ShawnHymel/YAS-0/Documentation/part-creation.png

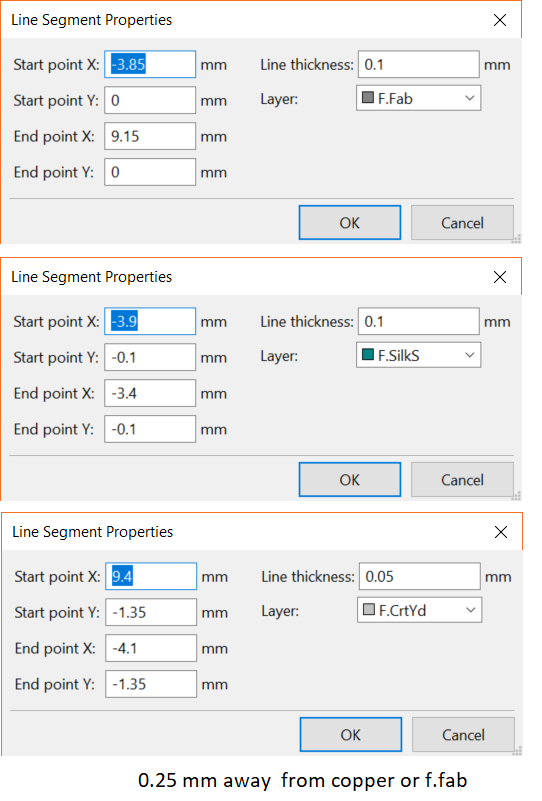
Documentation/part-creation.png
