ShawnHymel/YAS-0/Documentation/usb-impedance-calculation.png

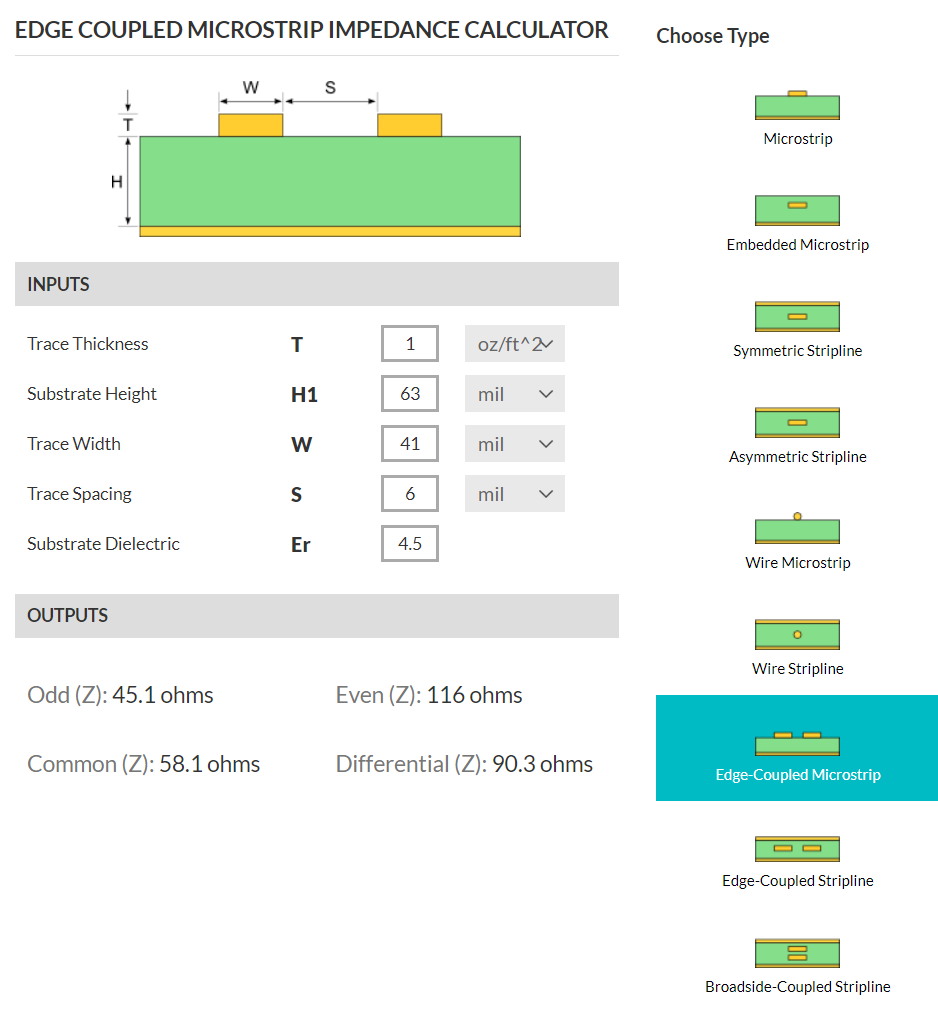
Documentation/usb-impedance-calculation.png
