ShawnHymel/YAS-0/Images/oshw-symbol.png

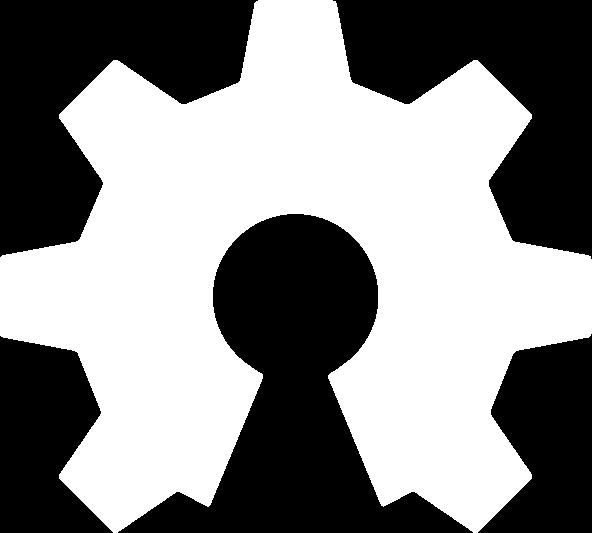
Images/oshw-symbol.png
