ShawnHymel/YAS-0/Hardware/STM32F070_Breakout/STM32F070_Breakout.pdf

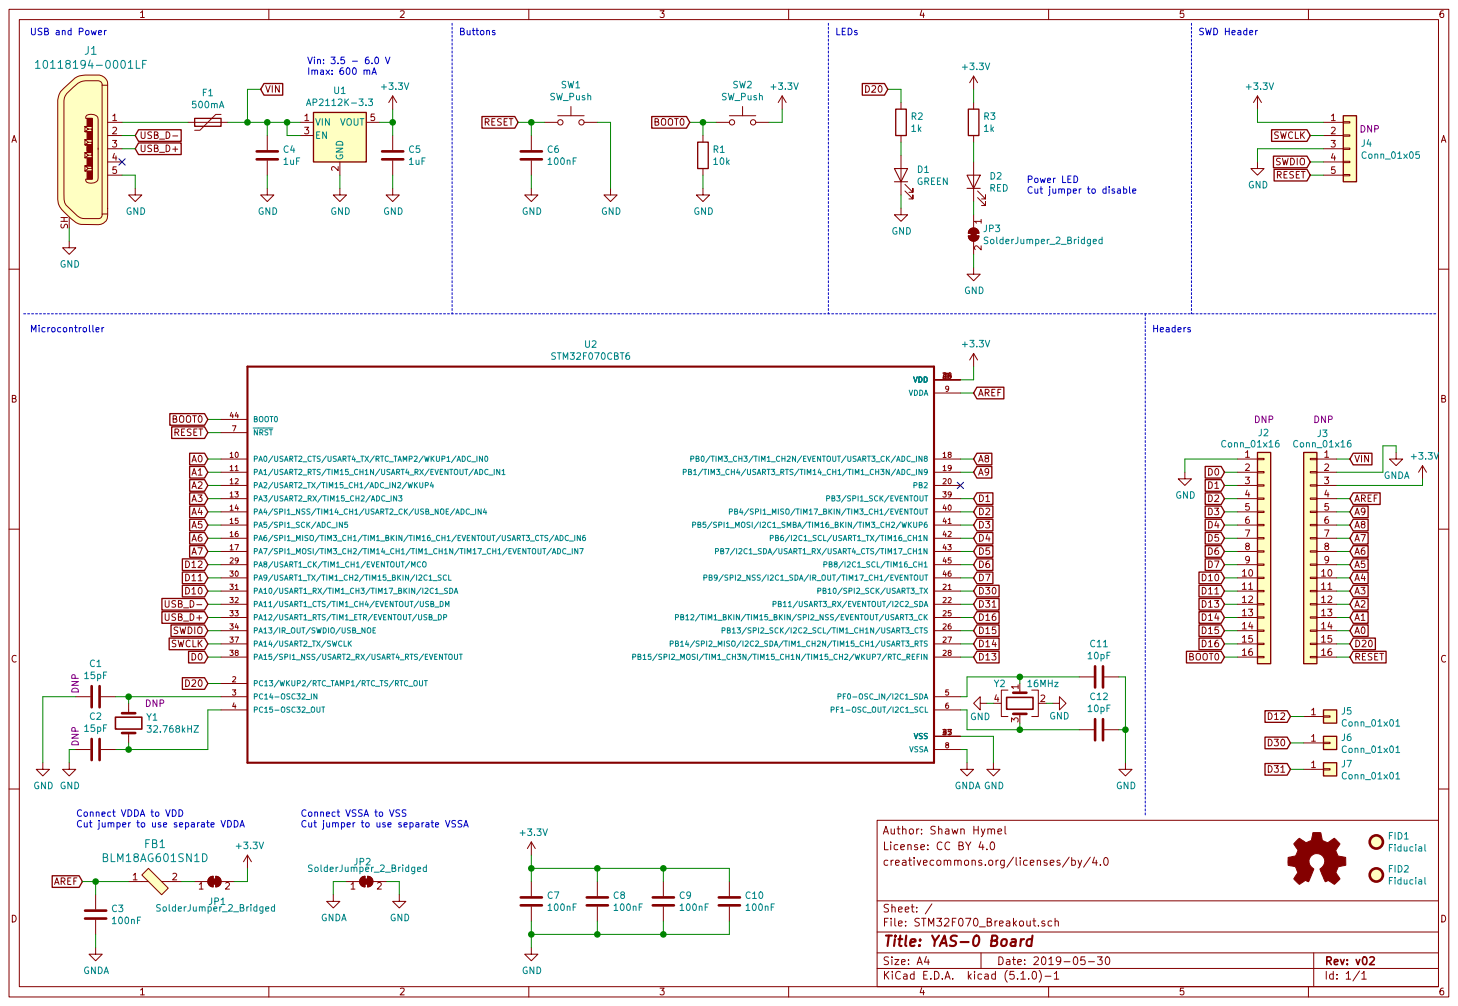
[picture p4: page 1]

JP1 SolderJumper_2_Bridged +3.3V Connect VDDA to VDD

License: CC BY 4.0 Author: Shawn Hymel

File: STM32F070_Breakout.sch Sheet: / creativecommons.org/licenses/by/4.0

Id: 1/1 Title: YAS-0 Board
