ShawnHymel/YAS-0/Hardware/STM32F070_Breakout/STM32F070_Breakout.kicad_pcb

## KiCad design Hardware/STM32F070_Breakout/STM32F070_Breakout.kicad_pcb (2019-08-29)

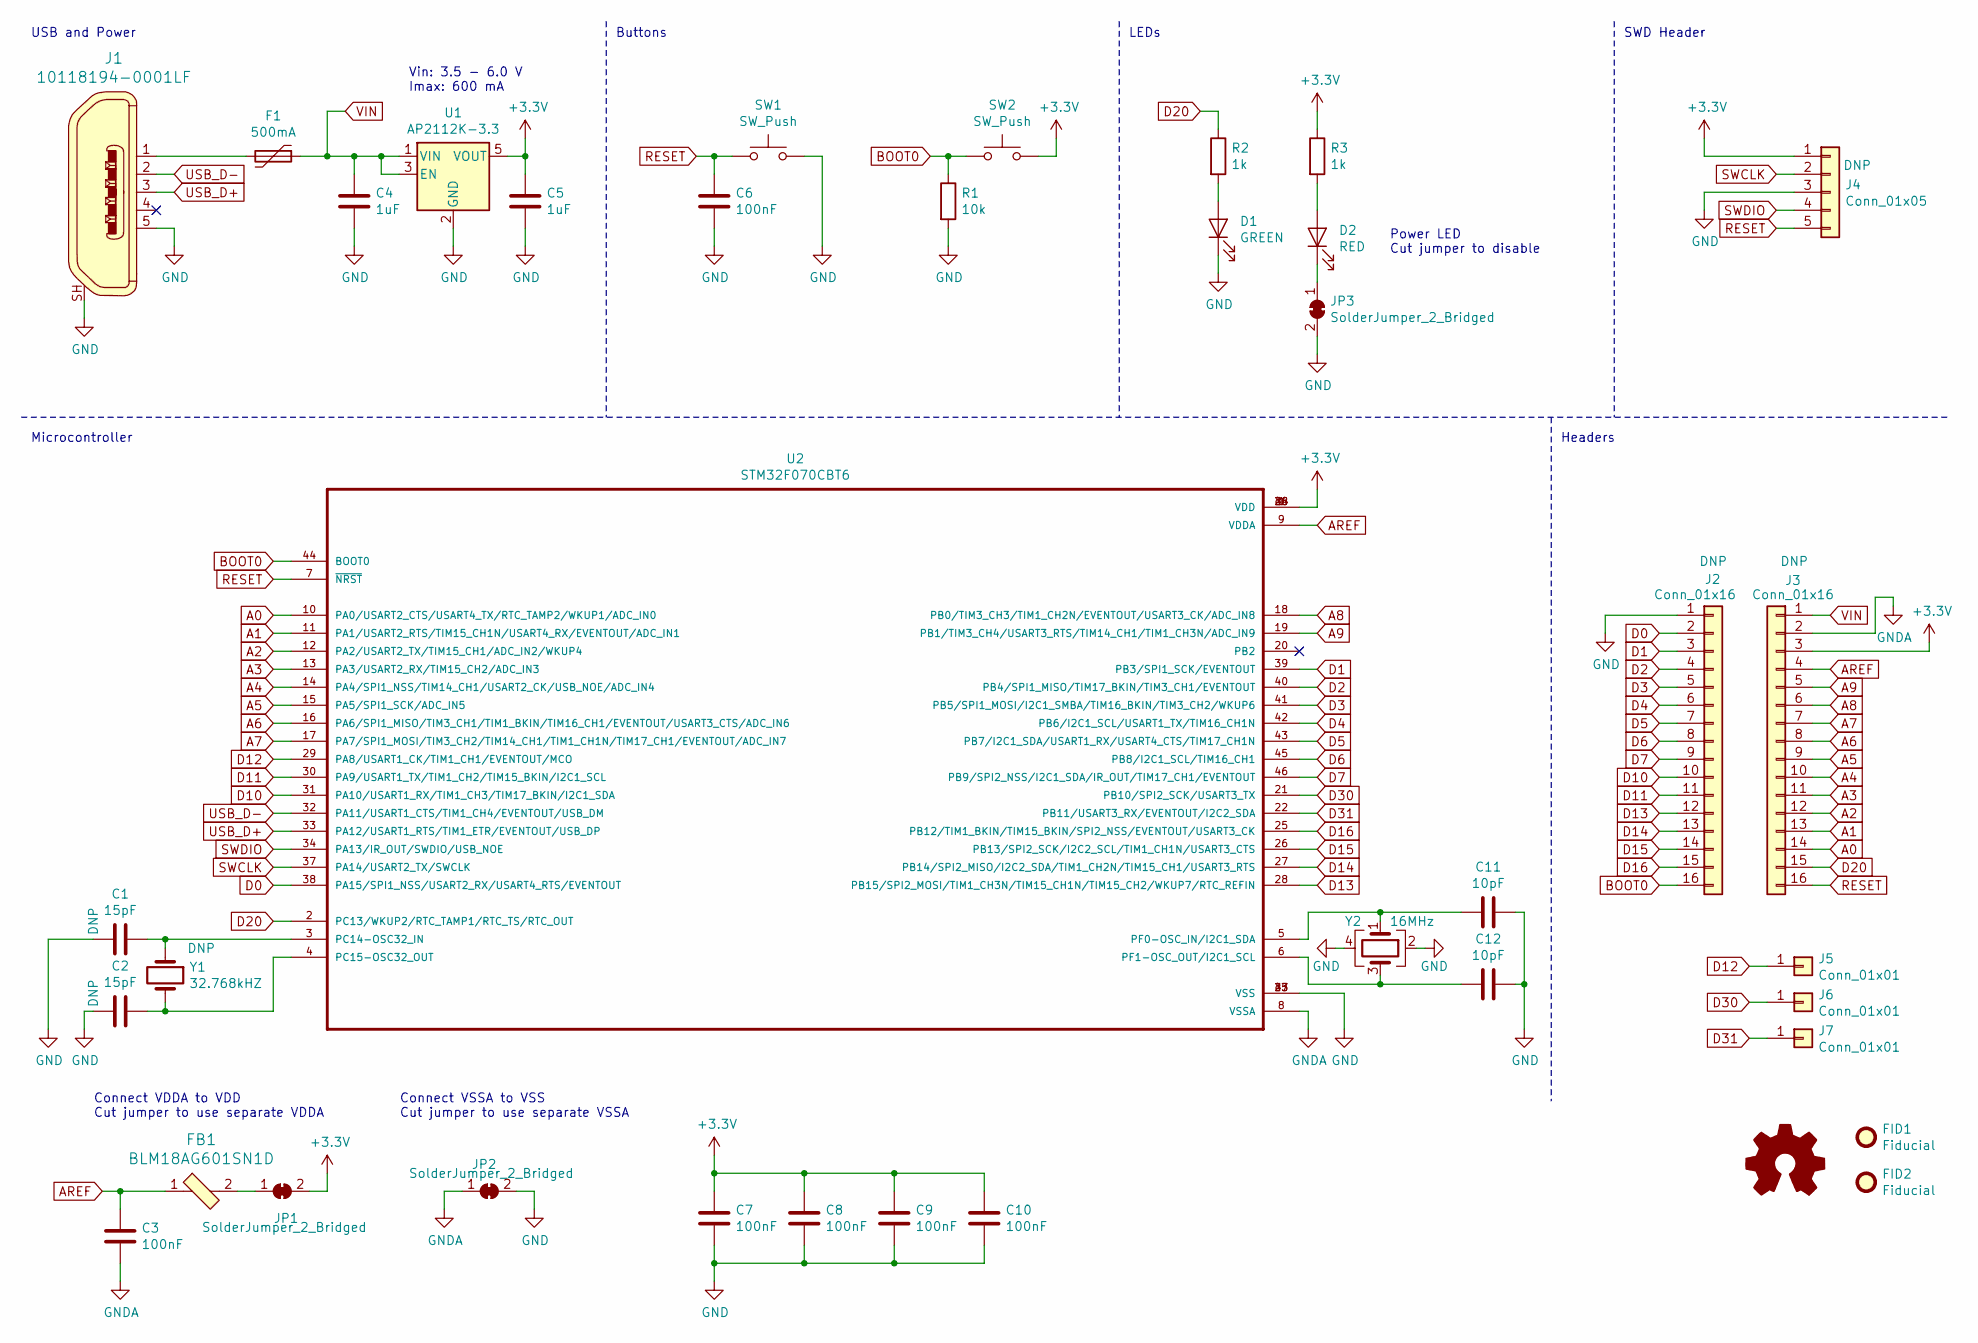
[picture p5: schematic STM32F070_Breakout.sch, YAS-0 Board]

Parts:
C1, C2: 15pF; C_0603_1608Metric
C3, C6, C7, C8, C9, C10: 100nF; C_0603_1608Metric
C4, C5: 1uF; C_0603_1608Metric
C11, C12: 10pF; C_0603_1608Metric
D1: GREEN; LED_0603
D2: RED; LED_0603
F1: 500mA; 0ZCK0050FF2E
FB1: BLM18AG601SN1D; R_0603_1608Metric; MPN BLM18AG601SN1D; Digi-Key_PN 490-1014-1-ND
FID1, FID2: Fiducial; Fiducial_1mm_Mask2mm
J1: 10118194-0001LF; USB_Micro_B_Female_10118194-0001LF_oversized_pads; MPN 10118194-0001LF; Digi-Key_PN 609-4618-1-ND
J2, J3: Conn_01x16; PinHeader_1x16_P2.54mm_Vertical_NoSilk
J4: Conn_01x05; PinHeader_1x05_P2.54mm_Vertical_NoSilk
J5, J6, J7: Conn_01x01; TestPoint_Pad_1.0x2.5mm
JP1, JP2, JP3: SolderJumper_2_Bridged; SolderJumper-2_P1.3mm_Bridged_RoundedPad1.0x1.5mm
R1: 10k; R_0603_1608Metric
R2, R3: 1k; R_0603_1608Metric
SW1, SW2: SW_Push; SW_SPST_PTS810
U1: AP2112K-3.3; SOT-23-5
U2: STM32F070CBT6; QFP50P900X900X160-48N
Y1: 32.768kHZ; Crystal_SMD_G8-2Pin_3.2x1.5mm
Y2: 16MHz; Crystal_SMD_SeikoEpson_TSX3225-4Pin_3.2x2.5mm

Connections:
+3V3: C5.1, C7.1, C8.1, C9.1, C10.1, J3.3, J4.1, JP1.2 (B), R3.1, SW2.2, U1.5 (VOUT), U2.1 (VDD), U2.24 (VDD), U2.36 (VDD), U2.48 (VDD)
A0: J3.14, U2.10 (PA0/USART2_CTS/USART4_TX/RTC_TAMP2/WKUP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)
A1: J3.13, U2.11 (PA1/USART2_RTS/TIM15_CH1N/USART4_RX/EVE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)
A2: J3.12, U2.12 (PA2/USART2_TX/TIM15_CH1/ADC_IN2/WKUP4)
A3: J3.11, U2.13 (PA3/USART2_RX/TIM15_CH2/ADC_IN3)
A4: J3.10, U2.14 (PA4/SPI1_NSS/TIM14_CH1/USART2_CK/USB_NO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)
A5: J3.9, U2.15 (PA5/SPI1_SCK/ADC_IN5)
A6: J3.8, U2.16 (PA6/SPI1_MISO/TIM3_CH1/TIM1_BKIN/TIM16_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)
A7: J3.7, U2.17 (PA7/SPI1_MOSI/TIM3_CH2/TIM14_CH1/TIM1_C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)
A8: J3.6, U2.18 (PB0/TIM3_CH3/TIM1_CH2N/EVENTOUT/USART3_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)
A9: J3.5, U2.19 (PB1/TIM3_CH4/USART3_RTS/TIM14_CH1/TIM1_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)
AREF: C3.1, FB1.1, J3.4, U2.9 (VDDA)
BOOT0: J2.16, R1.1, SW2.1, U2.44 (BOOT0)
D0: J2.2, U2.38 (PA15/SPI1_NSS/USART2_RX/USART4_RTS/EVEN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)
D1: J2.3, U2.39 (PB3/SPI1_SCK/EVENTOUT)
D2: J2.4, U2.40 (PB4/SPI1_MISO/TIM17_BKIN/TIM3_CH1/EVENT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)
D3: J2.5, U2.41 (PB5/SPI1_MOSI/I2C1_SMBA/TIM16_BKIN/TIM3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)
D4: J2.6, U2.42 (PB6/I2C1_SCL/USART1_TX/TIM16_CH1N)
D5: J2.7, U2.43 (PB7/I2C1_SDA/USART1_RX/USART4_CTS/TIM17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)
D6: J2.8, U2.45 (PB8/I2C1_SCL/TIM16_CH1)
D7: J2.9, U2.46 (PB9/SPI2_NSS/I2C1_SDA/IR_OUT/TIM17_CH1/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)
D10: J2.10, U2.31 (PA10/USART1_RX/TIM1_CH3/TIM17_BKIN/I2C1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)
D11: J2.11, U2.30 (PA9/USART1_TX/TIM1_CH2/TIM15_BKIN/I2C1_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)
D12: J5.1, U2.29 (PA8/USART1_CK/TIM1_CH1/EVENTOUT/MCO)
D13: J2.12, U2.28 (PB15/SPI2_MOSI/TIM1_CH3N/TIM15_CH1N/TIM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)
D14: J2.13, U2.27 (PB14/SPI2_MISO/I2C2_SDA/TIM1_CH2N/TIM15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)
D15: J2.14, U2.26 (PB13/SPI2_SCK/I2C2_SCL/TIM1_CH1N/USART3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)
D16: J2.15, U2.25 (PB12/TIM1_BKIN/TIM15_BKIN/SPI2_NSS/EVEN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)
D20: J3.15, R2.1, U2.2 (PC13/WKUP2/RTC_TAMP1/RTC_TS/RTC_OUT)
D30: J6.1, U2.21 (PB10/SPI2_SCK/USART3_TX)
D31: J7.1, U2.22 (PB11/USART3_RX/EVENTOUT/I2C2_SDA)
GND: C1.2, C2.2, C4.2, C5.2, C6.2, C7.2, C8.2, C9.2, C10.2, C11.1, C12.1, D1.1 (K), J1.5, J1.SH, J2.1, J4.3, JP2.2 (B), JP3.2 (B), R1.2, SW1.2, U1.2 (GND), U2.23 (VSS), U2.35 (VSS), U2.47 (VSS), Y2.2, Y2.4
GNDA: C3.2, J3.2, JP2.1 (A), U2.8 (VSSA)
unnamed: C1.1, U2.3 (PC14-OSC32_IN), Y1.1
unnamed: C2.1, U2.4 (PC15-OSC32_OUT), Y1.2
unnamed: C11.2, U2.5 (PF0-OSC_IN/I2C1_SDA), Y2.1
unnamed: C12.2, U2.6 (PF1-OSC_OUT/I2C1_SCL), Y2.3
unnamed: D1.2 (A), R2.2
unnamed: D2.1 (K), JP3.1 (A)
unnamed: D2.2 (A), R3.2
unnamed: F1.2, J1.1
unnamed: FB1.2, JP1.1 (A)
RESET: C6.1, J3.16, J4.5, SW1.1, U2.7 (~NRST~)
SWCLK: J4.2, U2.37 (PA14/USART2_TX/SWCLK)
SWDIO: J4.4, U2.34 (PA13/IR_OUT/SWDIO/USB_NOE)
USB_D+: J1.3, U2.33 (PA12/USART1_RTS/TIM1_ETR/EVENTOUT/USB_DP)
USB_D-: J1.2, U2.32 (PA11/USART1_CTS/TIM1_CH4/EVENTOUT/USB_DM)
VIN: C4.1, F1.1, J3.1, U1.1 (VIN), U1.3 (EN)

Notes on the sheet:
Power LED Cut jumper to disable
SWD Header
LEDs
USB and Power
Headers
Buttons
Connect VDDA to VDD Cut jumper to use separate VDDA
Connect VSSA to VSS Cut jumper to use separate VSSA
Microcontroller
Vin: 3.5 - 6.0 V Imax: 600 mA

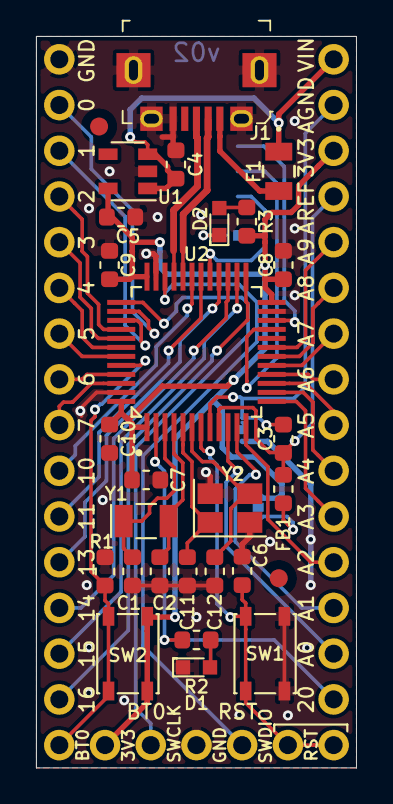
[picture p6: board STM32F070_Breakout.kicad_pcb from above]

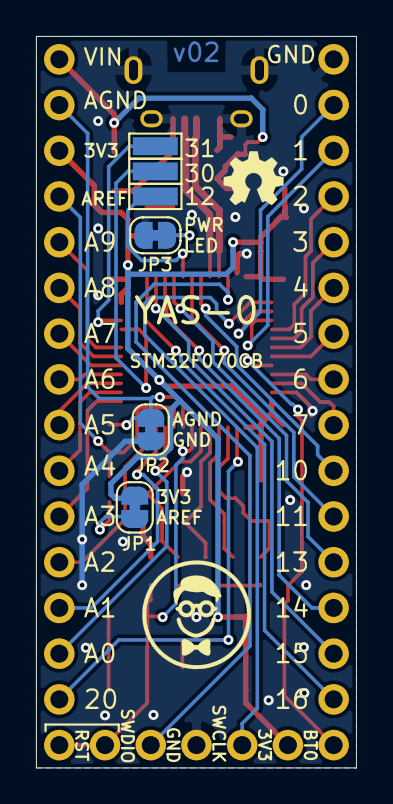
[picture p7: board STM32F070_Breakout.kicad_pcb from below]

Board: 2 copper layers, 17.8 x 40.6 mm, 37 parts (6 on the bottom side), 48 nets.
