ShawnHymel/YAS-0/(commit log)

2019-06-01 Initial commit. Almost done with schematic.
    [STM32F070_Breakout.kicad_pcb, STM32F070_Breakout.sch]
2019-06-01 Finished schematic
    [STM32F070_Breakout.sch]
2019-06-01 Associated symbols with footprints
    [STM32F070_Breakout.kicad_pcb, STM32F070_Breakout.sch]
2019-06-04 Moved components around. Created BOM.
    [STM32F070_Breakout.csv, STM32F070_Breakout.kicad_pcb, STM32F070_Breakout.xlsx]
2019-06-05 Components placed
    [STM32F070_Breakout.kicad_pcb, STM32F070_Breakout.sch, STM32F070_Breakout_BOM.xlsx]
2019-06-06 Layout done
    [STM32F070_Breakout.kicad_pcb, STM32F070_Breakout.sch]
2019-06-07 Version v01 complete and sent for fab.
    [STM32F070_Breakout.kicad_pcb, STM32F070_Breakout.sch]
2019-08-07 Finished v02 layout
    [STM32F070_Breakout.kicad_pcb, STM32F070_Breakout.sch]
2019-08-29 Added schematic pdf
    [STM32F070_Breakout-B_Cu.gbl, STM32F070_Breakout-B_Mask.gbs, STM32F070_Breakout-B_Paste.gbp, STM32F070_Breakout-B_SilkS.gbo, STM32F070_Breakout-F_Cu.gtl, STM32F070_Breakout-F_Mask.gts, STM32F070_Breakout-F_Paste.gtp, STM32F070_Breakout-F_SilkS.gto]
